hidvegarpi/Prog2_Project/README.MD

Project Soyuz - Work in Progress
===

This project started with a __simple__ idea, let's make a phone from an old radio.
The radio, which from the design started, is from one of my old friend, who found it at a garbage disposal.

I will be thankful for any suggestions on how to improve the design.

Hardware
---

* [LILYGO TTGO T-CALL ESP32 SIM800L](https://www.aliexpress.com/item/33045221960.html "Order here")
* [1602 LCD Display](https://www.hestore.hu/prod_10036401.html "Order here")
* [I2C LCD Driver](https://www.hestore.hu/prod_10035516.html "Order here")
* [BME280 Temperature and humidity sensor](https://www.hestore.hu/prod_10039068.html "Order here")
* [Rotary encoder](https://www.hestore.hu/prod_10040813.html "Order here")
* [Push button](https://www.hestore.hu/prod_10028247.html "Order here")
* [2 x Rocker switch](https://www.hestore.hu/prod_10028128.html "Order here")
* [Slide switch](https://www.hestore.hu/prod_10042063.html "Order here")
* 4 x White led
* 4 x 470 ohm resistor
* 2 x 220 kohm resistor
* Microphone
* 8 ohm speaker
* [Li-ion battery charger](https://www.hestore.hu/prod_10042093.html "Order here")
* [DC-DC Boost converter](https://www.hestore.hu/prod_10042081.html "Order here")
* [5V Voltage regulator LM1084IT-5.0](https://www.hestore.hu/prod_10026480.html "Order here")
* 3 x 18650 battery
* [3 x 18650 battery case](https://www.hestore.hu/prod_10037304.html "Order here")
* 2 x Custom PCB, designs included [here](https://github.com/hidvegarpi/Prog2_Project/tree/main/PCB%20files) ([you can order them here](https://jlcpcb.com/ "JLC PCB"))

Needed for assembly
---

* Programming
	* Arduino IDE
	* USB-C cable
* Mounting material
	* Wire
	* Solder wire
	* Insulating tape
	* Heatshrink
* Tools
	* Soldering iron
	* Wire cutter
	
The menu of the phone
---

1. Main page (shows date, time, battery charge, temperature, signal strength)
1. Contact list (saved contacts readed from flash memory of ESP32)
1. Messages (you get a message, if you have a missed call)
1. Restart (reboot the phone)
1. Dial number (you can dial a number if you want to call without saving it)
1. Save contact (save a phone number with a contact name)
1. Delete contact (no need to explain)
1. Change in call volume
1. Change ringer volume

You can select the above menu items by pressing the sidebutton, the rotary encoder is used for scrolling between them.
If the sidebutton is pressed, while on the main page, the backlight will turn OFF/ON.
If the backlight is off, any input will be ignored except for one, the sidebutton is used to turn the backlight on again.

Schematics
---
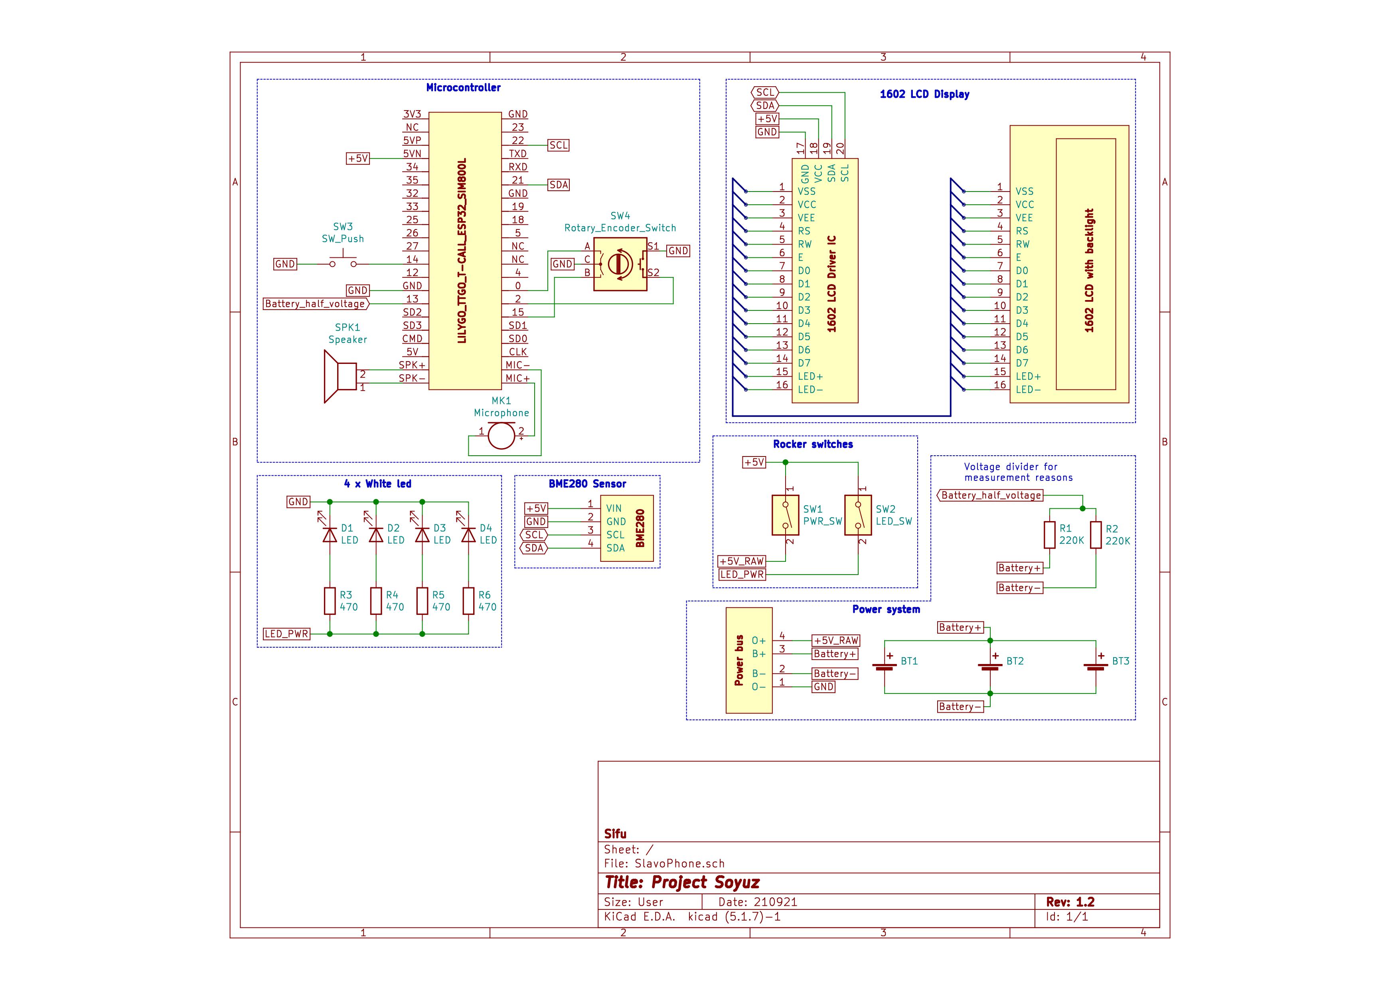
[picture p1: PCB files/Schematics/Project Soyuz Schematic.jpg]
Schematic
||
|:--:|
|*Main board*|
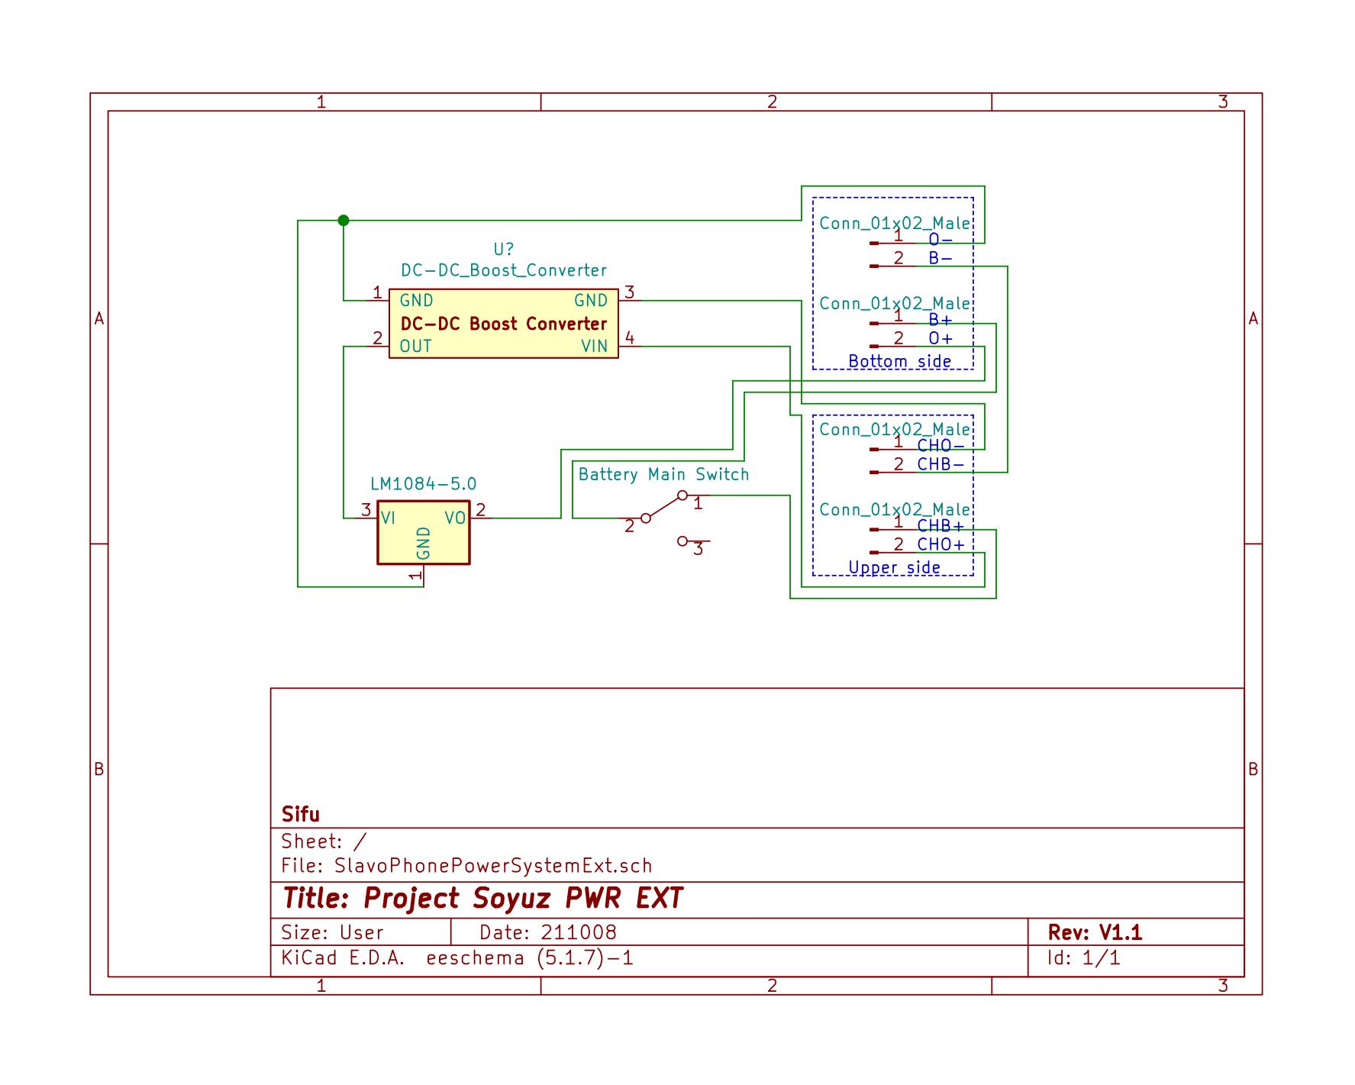
[picture p2: PCB files/Schematics/Project Soyuz PWR EXT Schematic.jpg]
Schematic
||
|*Power management extension (will be updated)*|

3D render of internal components EARLY RENDERS
---

|Early render|
|:--:|
|*Early render*|

https://user-images.githubusercontent.com/31046450/134319409-6e0832f5-5e43-4a4f-a9e3-da5d3e70531a.mp4

Rendering took around 13 hours.
