hidvegarpi/Prog2_Project/PCB files/Schematics/Project Soyuz PWR EXT Schematic.pdf

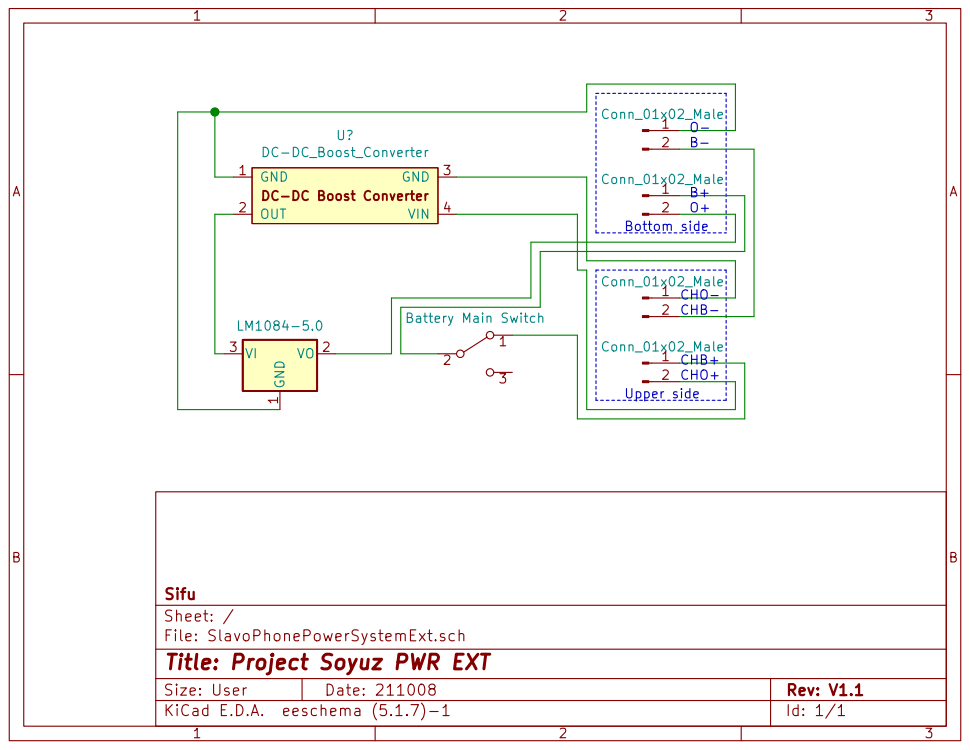
[picture p3: page 1]

2 Conn_01x02_Male CHB+ CHO+ CHO- CHB- B+O+ O- B- Upper side Bottom side

File: SlavoPhonePowerSystemExt.sch Sheet: / Sifu

Id: 1/1 Title: Project Soyuz PWR EXT
