hidvegarpi/Prog2_Project/PCB files/Schematics/Project Soyuz Schematic.pdf

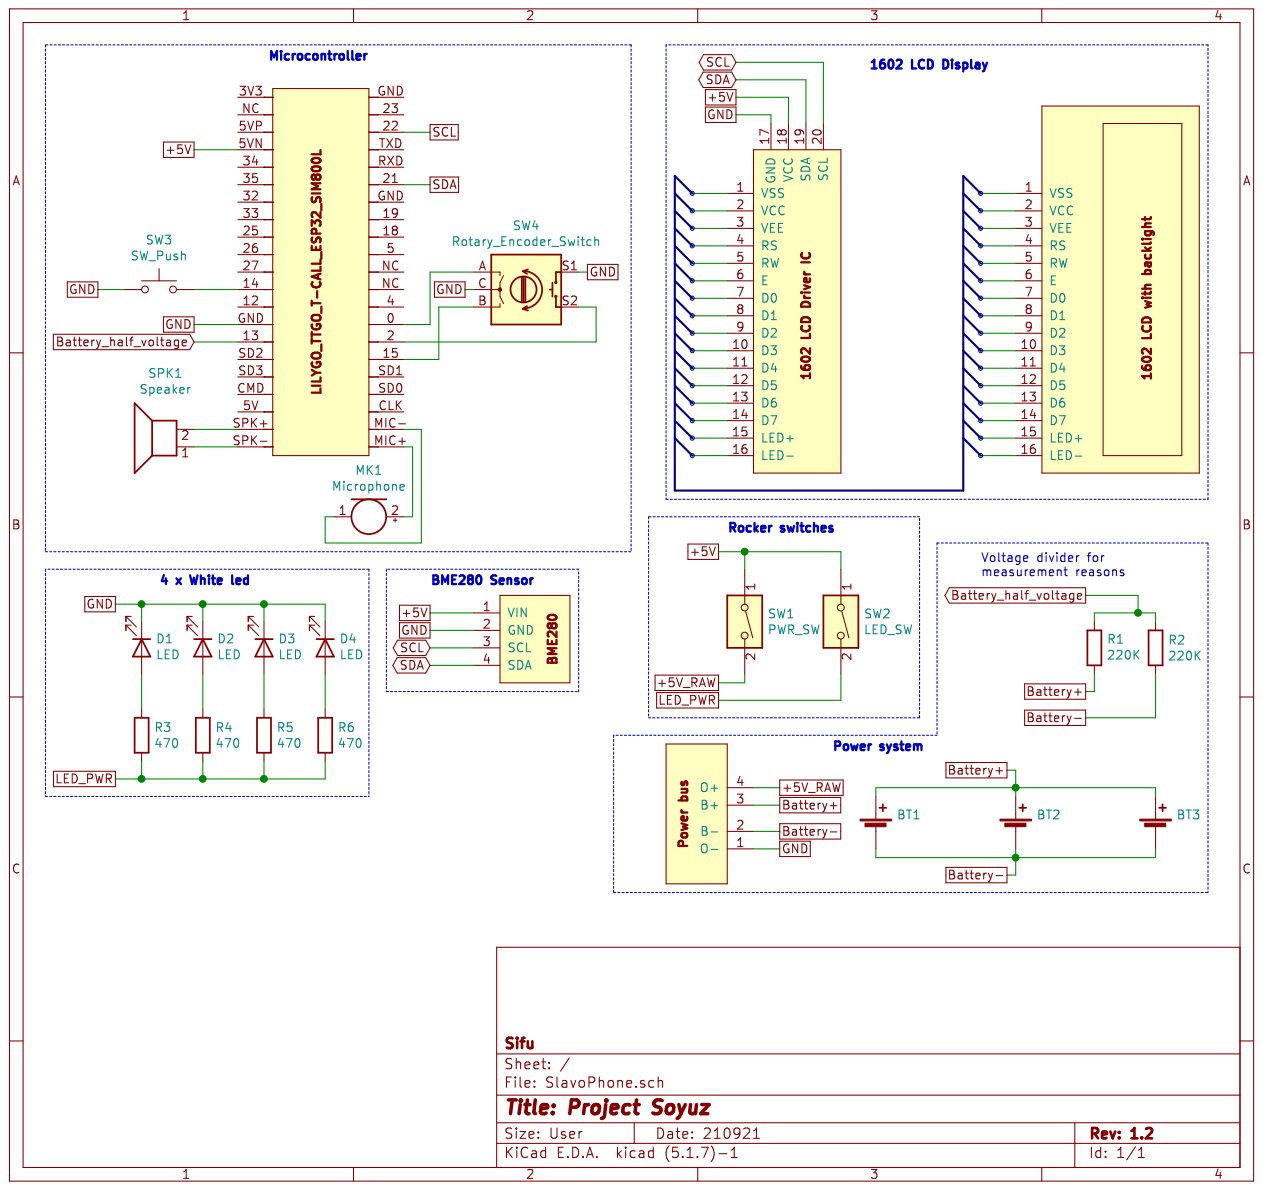
[picture p4: page 1]
