hidvegarpi/Prog2_Project/(commit log)

2021-09-20 Added a schematic
    File management, new schematic
2021-09-21 Added main schematic
    Readme fix
2021-09-21 Added PCB files
    File management
2021-09-21 Added schematic images
2021-09-21 Added gerber files
2021-10-08 Update gerber files
2021-10-08 Schematic update
